tanguyenhoangminh/Edge-Cloud-AI-IoT-System-for-Smart-Hotel-Management/hotel_project_mosquitto_cloudDb/assets/family_main.png

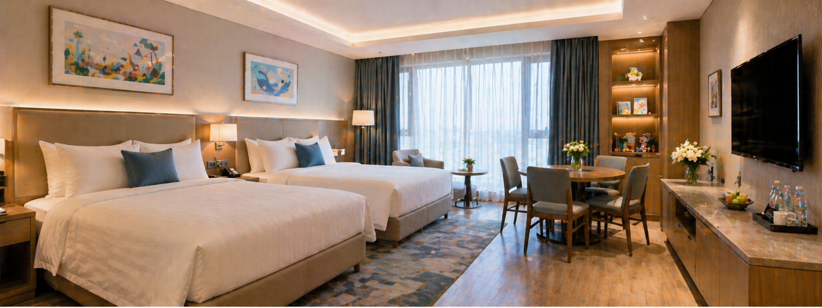
hotel_project_mosquitto_cloudDb/assets/family_main.png
