tanguyenhoangminh/Edge-Cloud-AI-IoT-System-for-Smart-Hotel-Management/hotel_project_mosquitto_cloudDb/assets/family_t2.png

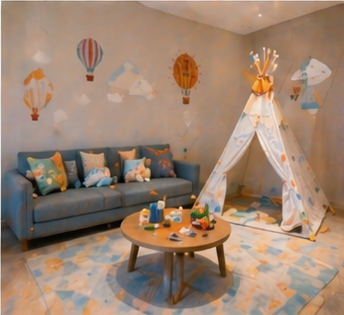
hotel_project_mosquitto_cloudDb/assets/family_t2.png
