tanguyenhoangminh/Edge-Cloud-AI-IoT-System-for-Smart-Hotel-Management/hotel_project_mosquitto_cloudDb/assets/single_main.png

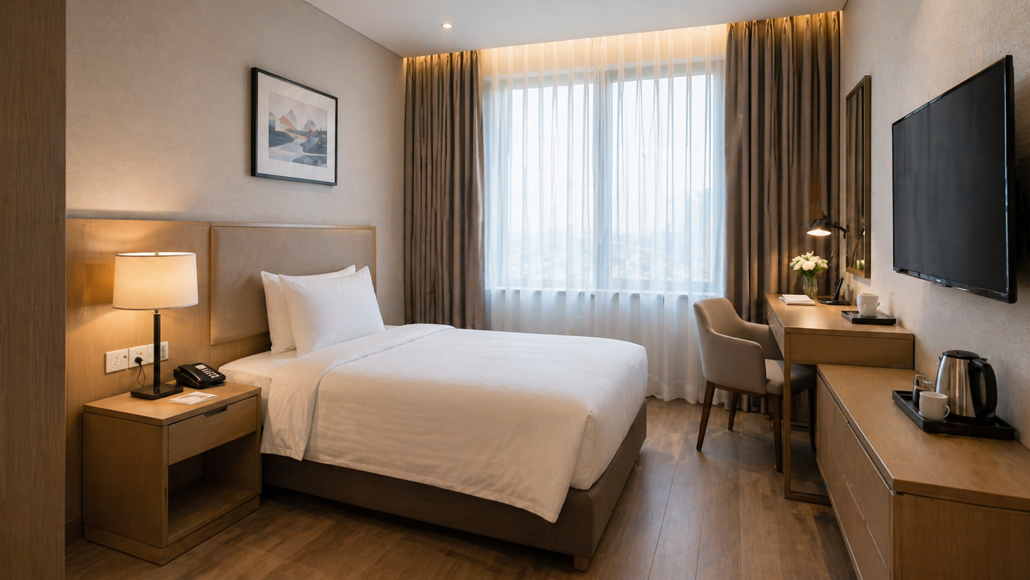
hotel_project_mosquitto_cloudDb/assets/single_main.png
