tanguyenhoangminh/Edge-Cloud-AI-IoT-System-for-Smart-Hotel-Management/(commit log)

2026-09-06 Initial commit - push
    [model_comparison.csv, realworld_log.csv]
2026-09-06 Fix submodule, add nested folders
    [ESP8266_Node_1.ino, ESP8266_Node_2.ino]
